A3Analytics/gizmonic-cambot/hardware/cambot-minimum-petg-kit/plates/03_dual_magnet_foot.3mf

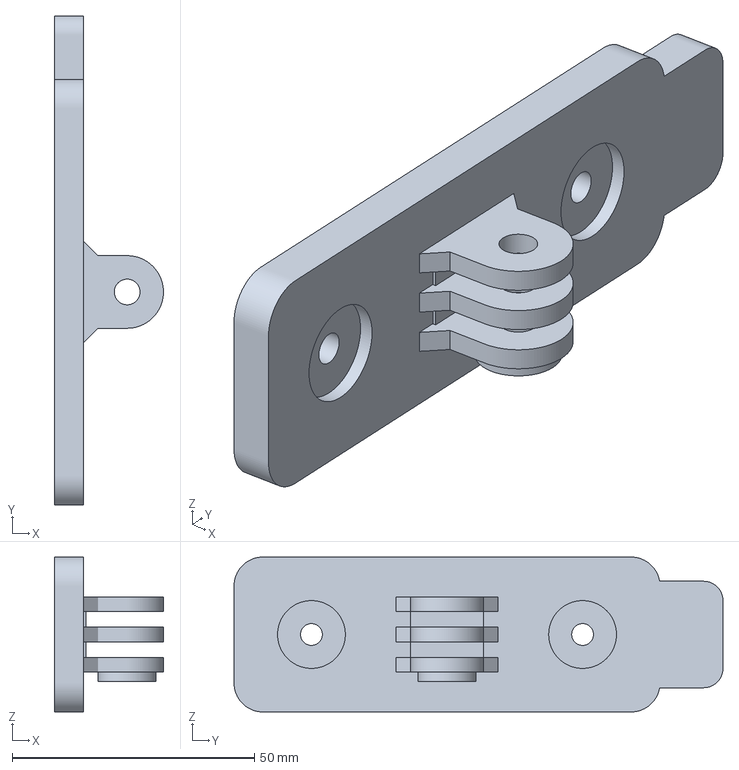
[picture p4: CAD file, 2026-11-05]
hardware/cambot-minimum-petg-kit/plates/03_dual_magnet_foot.3mf
22.5 x 101.0 x 32.0 mm
