A3Analytics/gizmonic-cambot/hardware/cambot-minimum-petg-kit/step/rod_female_25_6-32.step

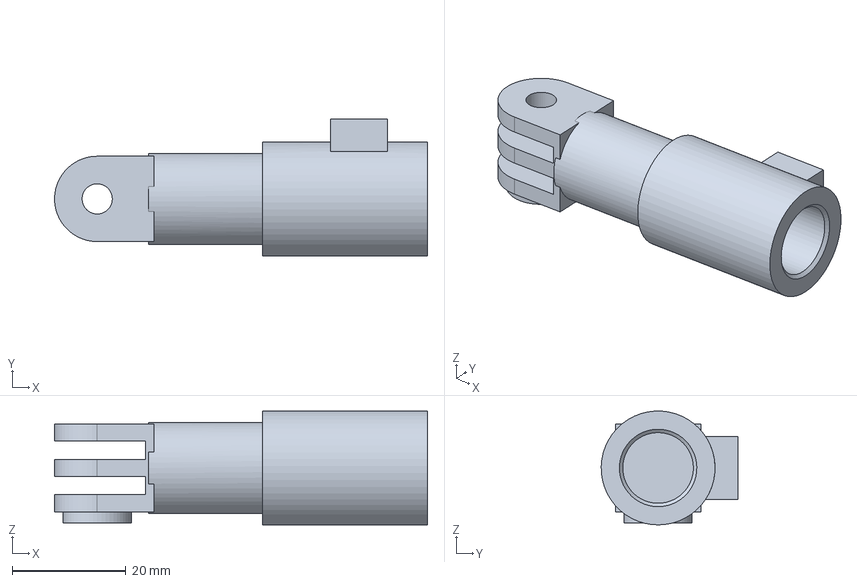
[picture p5: CAD file, 2026-11-05]
hardware/cambot-minimum-petg-kit/step/rod_female_25_6-32.step
65.5 x 24.0 x 20.0 mm
