A3Analytics/gizmonic-cambot/hardware/cambot-minimum-petg-kit/plates/01_case_and_short_retainer.3mf

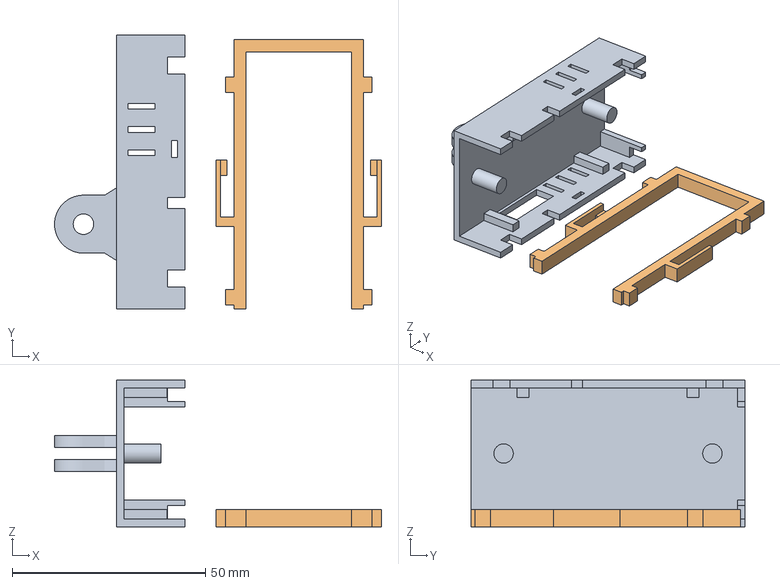
[picture p6: CAD file, 2026-11-05]
hardware/cambot-minimum-petg-kit/plates/01_case_and_short_retainer.3mf
84.6 x 71.0 x 38.0 mm
housing_v3
retainer_v3_short
