A3Analytics/gizmonic-cambot/hardware/cambot-minimum-petg-kit/step/rod_female_50_6-32.step

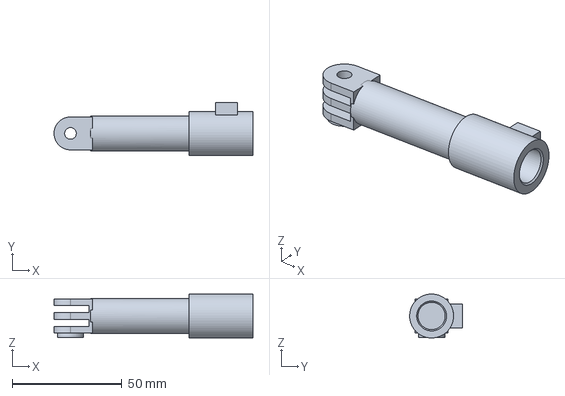
[picture p7: CAD file, 2026-11-05]
hardware/cambot-minimum-petg-kit/step/rod_female_50_6-32.step
90.5 x 24.0 x 20.0 mm
