A3Analytics/gizmonic-cambot/hardware/cambot-minimum-petg-kit/plates/02_arms_25_and_50.3mf

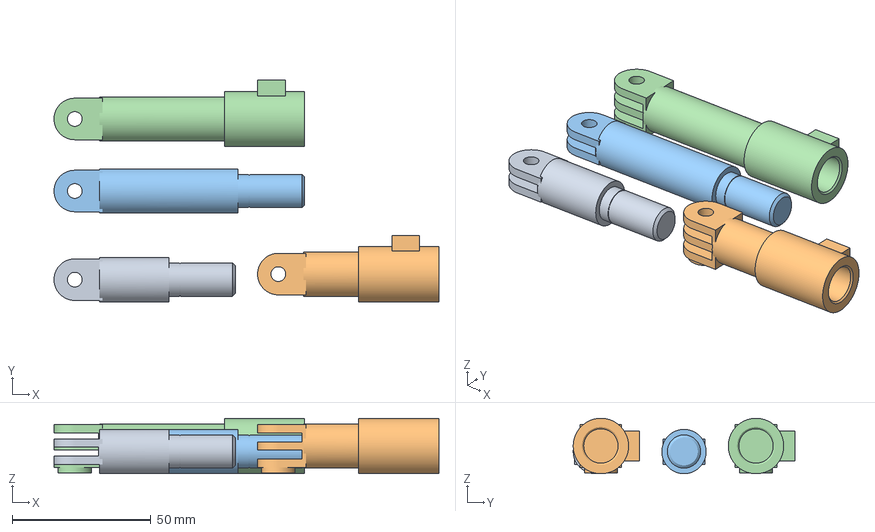
[picture p8: CAD file, 2026-11-05]
hardware/cambot-minimum-petg-kit/plates/02_arms_25_and_50.3mf
139.0 x 80.0 x 20.0 mm
rod_male_25
rod_female_25_6-32
rod_male_50
rod_female_50_6-32
