A3Analytics/gizmonic-cambot/hardware/cambot-minimum-petg-kit/step/housing_v3.step

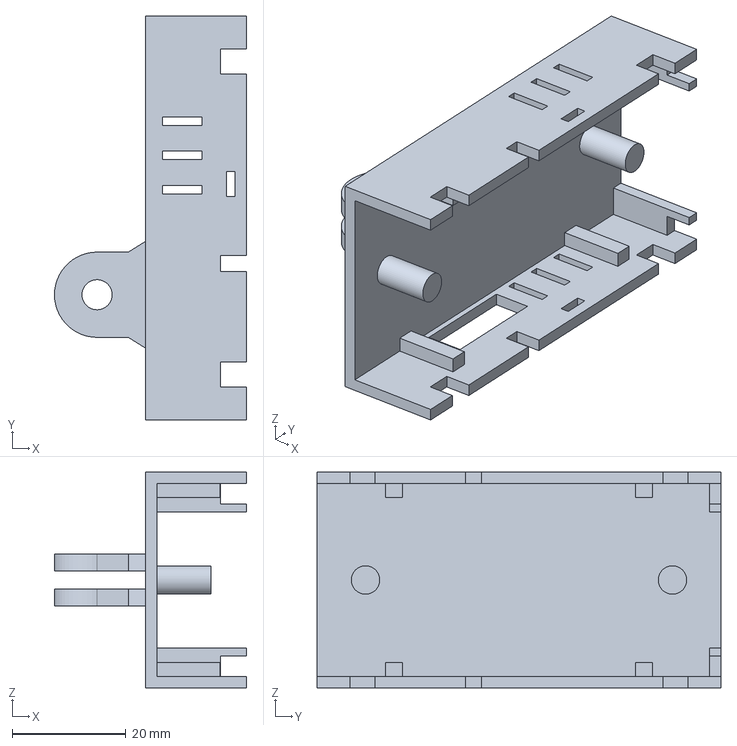
[picture p9: CAD file, 2026-11-05]
hardware/cambot-minimum-petg-kit/step/housing_v3.step
33.8 x 71.0 x 38.0 mm
