A3Analytics/gizmonic-cambot/hardware/cambot-minimum-petg-kit/step/rod_male_50.step

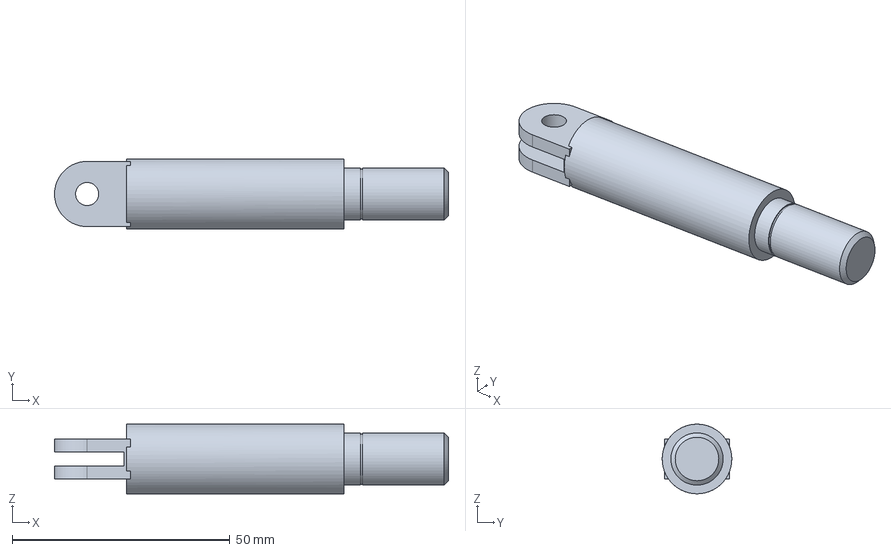
[picture p10: CAD file, 2026-11-05]
hardware/cambot-minimum-petg-kit/step/rod_male_50.step
90.5 x 16.0 x 16.0 mm
