A3Analytics/gizmonic-cambot/hardware/cambot-minimum-petg-kit/step/retainer_v3_short.step

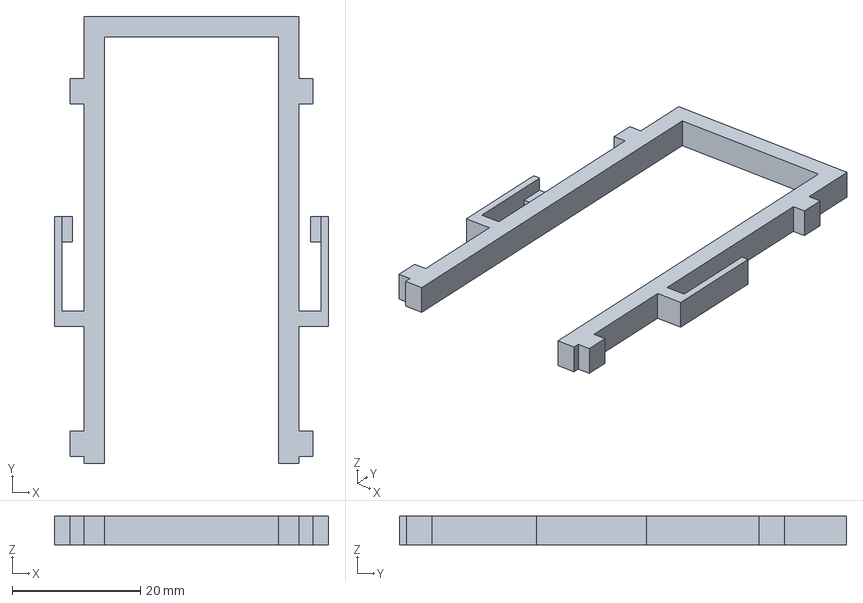
[picture p11: CAD file, 2026-11-05]
hardware/cambot-minimum-petg-kit/step/retainer_v3_short.step
42.8 x 69.8 x 4.50 mm
