A3Analytics/gizmonic-cambot/hardware/cambot-minimum-petg-kit/step/rod_male_25.step

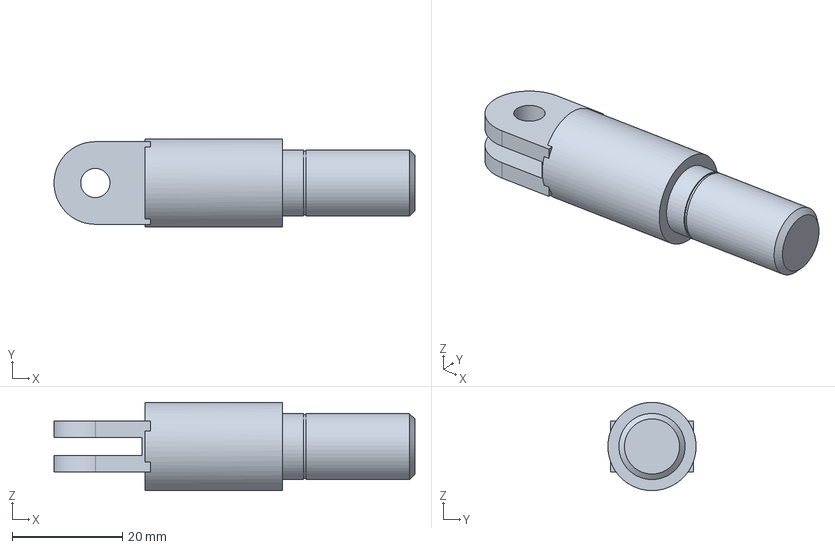
[picture p12: CAD file, 2026-11-05]
hardware/cambot-minimum-petg-kit/step/rod_male_25.step
65.5 x 16.0 x 16.0 mm
