A3Analytics/gizmonic-cambot/(list of files, cad)

Other CAD files:
hardware/cambot-minimum-petg-kit/step/dual_magnet_foot.step
hardware/cambot-minimum-petg-kit/3mf/dual_magnet_foot.3mf
hardware/cambot-minimum-petg-kit/3mf/housing_v3.3mf
hardware/cambot-minimum-petg-kit/3mf/retainer_v3_short.3mf
hardware/cambot-minimum-petg-kit/3mf/rod_female_25_6-32.3mf
hardware/cambot-minimum-petg-kit/3mf/rod_female_50_6-32.3mf
hardware/cambot-minimum-petg-kit/3mf/rod_male_25.3mf
hardware/cambot-minimum-petg-kit/3mf/rod_male_50.3mf
hardware/cambot-minimum-petg-kit/stl/dual_magnet_foot.stl
hardware/cambot-minimum-petg-kit/stl/housing_v3.stl
hardware/cambot-minimum-petg-kit/stl/retainer_v3_short.stl
hardware/cambot-minimum-petg-kit/stl/rod_female_25_6-32.stl
hardware/cambot-minimum-petg-kit/stl/rod_female_50_6-32.stl
hardware/cambot-minimum-petg-kit/stl/rod_male_25.stl
hardware/cambot-minimum-petg-kit/stl/rod_male_50.stl
