A3Analytics/gizmonic-cambot/test/fixtures/pipette_tip_no.jpg

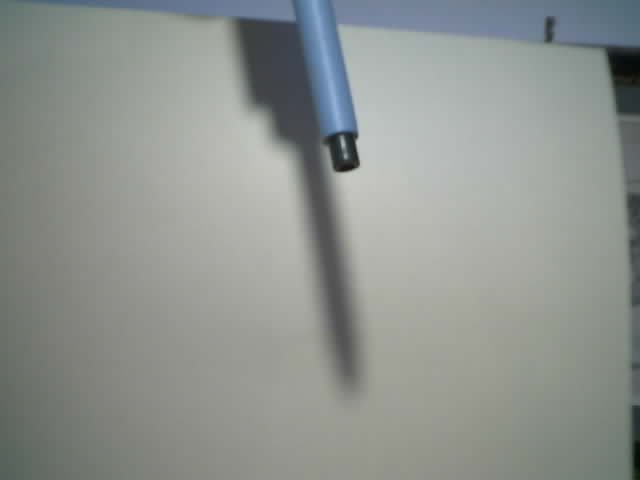
test/fixtures/pipette_tip_no.jpg
