A3Analytics/gizmonic-cambot/test/fixtures/pipette_tip_yes.jpg

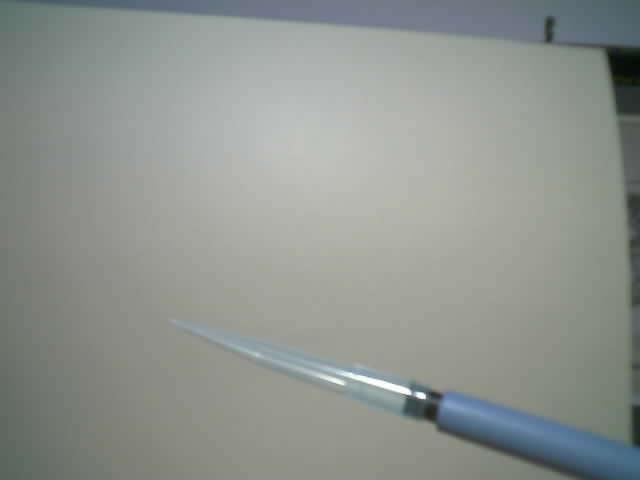
test/fixtures/pipette_tip_yes.jpg
