A3Analytics/gizmonic-cambot/(commit log)

2026-10-31 Add the Witness camera specification and the board notes it was written from.
2026-10-31 Add the FIXR setup path so a camera can join Wi-Fi and register itself.
    An agent follows the host profile and setup test, and the registrar lists each camera and refreshes its frame.
    [bringup.c]
2026-10-31 Move camera setup into FIXR and add the firmware that records and asks a model.
    Future agents can follow the shared guide plus a per-computer profile, and the camera now has time, recording, storage, and model clients beside the host-side index and tests.
    [bringup.c]
2026-10-31 Plan on-device indexing and the registrar caption.
2026-10-31 Index video on the camera and show the latest caption in the registrar.
    The ESP32 scores motion, picks keyframes, and writes captions to the card so a host machine is no longer in the recording path.
    [bringup.c]
2026-11-02 Add a registrar query box and a switch to pause indexing.
    Questions are answered on this computer from the camera index, and indexing stays off until the switch is turned on so the camera does not call the model on its own.
2026-11-02 Stop live-view flicker and add pause/download for frames.
    Reuse the camera card and keep the displayed JPEG blob so updates
    do not flash and downloads match what is on screen.
2026-11-02 Add on-camera JEV nouls with examples, boxes, and alerts.
    Split GPT and JEV indexing so the camera can score yes/no questions itself, store example images and optional Slack webhooks on the card, and show boxes in the registrar.
2026-11-04 Tighten JEV UI cadence and add registrar Dev mode.
    Refresh idle keyframes every 5s, boot with indexing off, and add Dev mode plus UX tests so quiet scenes and tip nouls stay usable without leaving GPT/JEV running overnight.
    [bringup.c]
2026-11-05 Make JEV updates steady and add High performance mode.
    JEV scores reached the page only sporadically: each TLS handshake used
    internal RAM, SD writes then failed for lack of DMA memory, and the
    recorder stopped submitting keyframes until the next minute. TLS and
    Wi-Fi buffers now live in PSRAM, a failed write reopens the segment,
    keyframes go to the indexer regardless of SD, the JEV connection is
    kept alive, and the indexer always scores the newest frame. Scores now
    update about every 1.7 s (worst 4.8 s in an 8-minute soak).
    Also adds the cached live preview, the High performance switch and
    /api/v1/perf, 1.5 s keyframes, ranged recordings scans, registrar poll
    serialization, and the jev_wat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
    [bringup.c, jev_watch.py, perf_check.py]
2026-11-05 Add the minimum PETG 3D-printable case kit under hardware/.
    Release 2026-11-04 (CERN-OHL-P-2.0): v3 housing, short retainer, 25 and
    50 mm arms, and the dual-magnet foot as STL, STEP, 3MF and three print
    plates, with the CadQuery generators and validation checks. Checksums in
    manifest.json verified; source/verify_release.py passes.
    [01_case_and_short_retainer.3mf, 02_arms_25_and_50.3mf, 03_dual_magnet_foot.3mf, dual_magnet_foot.3mf, dual_magnet_foot.step, dual_magnet_foot.stl, housing_v3.3mf, housing_v3.step]
2026-11-05 Point AGENTS.md at the firmware and the printable case kit.
2026-11-05 Answer questions from RAM so the camera stays reachable.
2026-11-07 Rename Witness to Gizmonic Cambot across the repository.
    Align product name, paths, packages, env vars, and docs with the gizmonic-cambot GitHub repo.
    [01_case_and_short_retainer.3mf, 02_arms_25_and_50.3mf, 03_dual_magnet_foot.3mf, dual_magnet_foot.3mf, dual_magnet_foot.step, dual_magnet_foot.stl, housing_v3.3mf, housing_v3.step]
2026-11-13 Prepare the repository for public release.
    Drop private reference material, anonymize host profiles, attach licenses, and make the README agent-first with board, mount BOM, and setup guidance.
